fhswf/LEDScheinwerfer/ESP8266/3D-Daten/Servohalter-3DDruck.stl

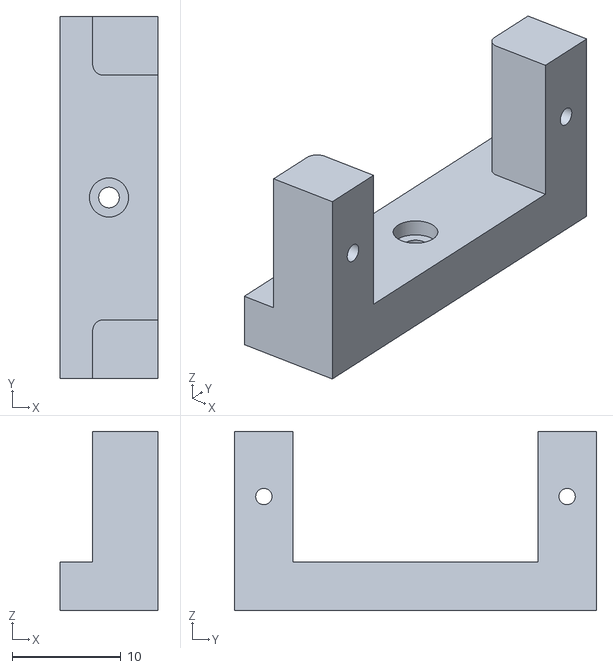
[picture p1: CAD file, 2024-04-04]
ESP8266/3D-Daten/Servohalter-3DDruck.stl
9.00 x 33.3 x 16.5
