fhswf/LEDScheinwerfer/ESP8266/3D-Daten/Seitenteil1.stl

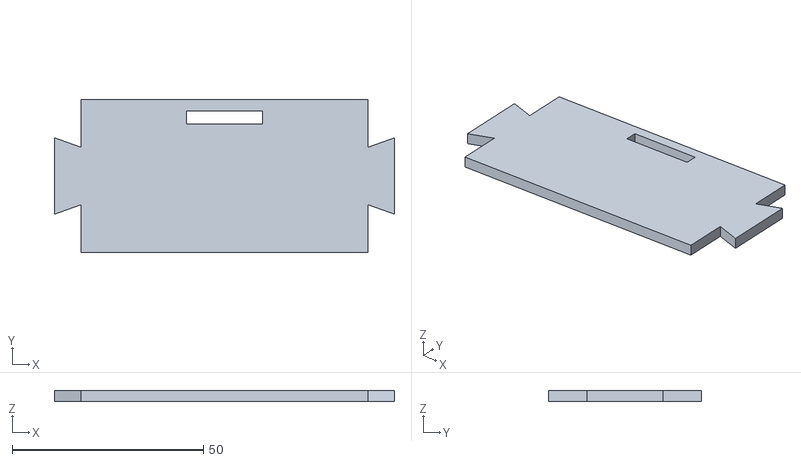
[picture p2: CAD file, 2024-04-04]
ESP8266/3D-Daten/Seitenteil1.stl
89.0 x 40.0 x 3.00
