fhswf/LEDScheinwerfer/ESP8266/3D-Daten/LED_Halter.stl

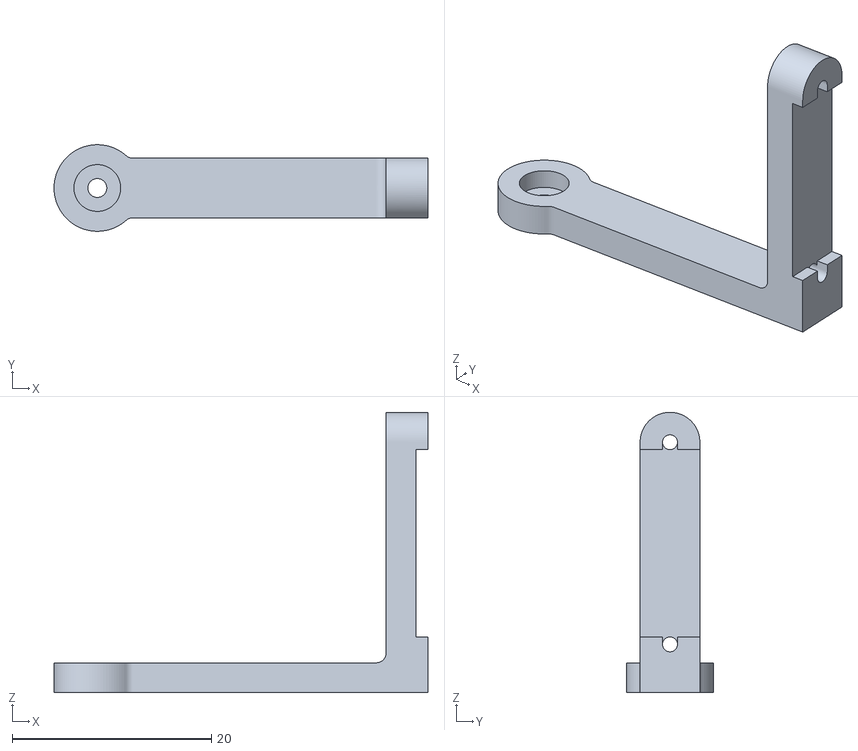
[picture p3: CAD file, 2024-04-04]
ESP8266/3D-Daten/LED_Halter.stl
37.5 x 8.70 x 28.1
