fhswf/LEDScheinwerfer/ESP8266/3D-Daten/Linse.stl

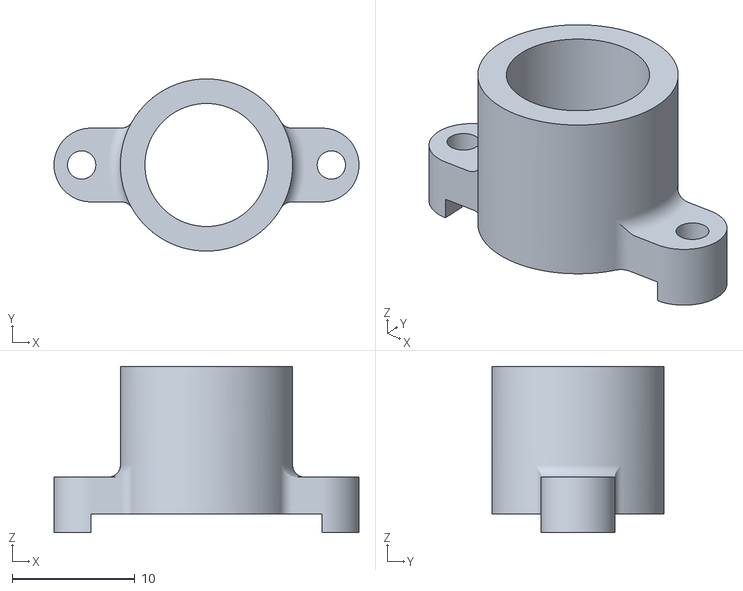
[picture p4: CAD file, 2024-04-04]
ESP8266/3D-Daten/Linse.stl
24.8 x 14.0 x 13.5
