fhswf/LEDScheinwerfer/ESP8266/3D-Daten/Platte.stl

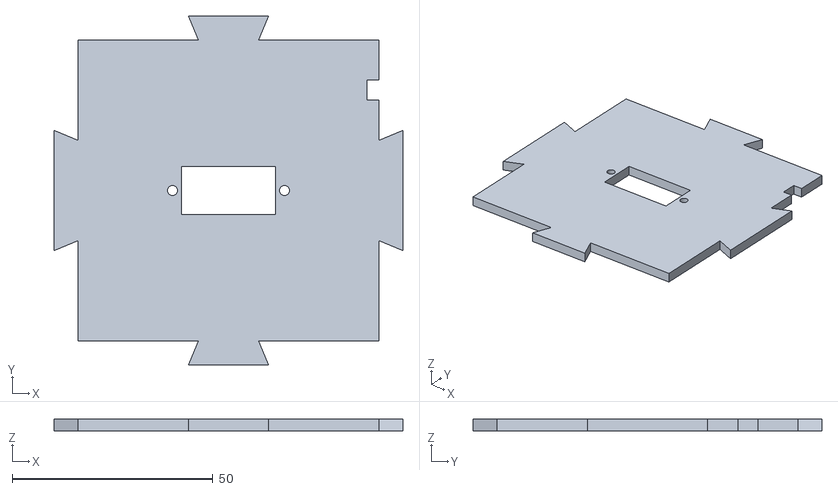
[picture p5: CAD file, 2024-04-04]
ESP8266/3D-Daten/Platte.stl
87.0 x 87.0 x 3.00
