fhswf/LEDScheinwerfer/ESP8266/3D-Daten/Seitenteil2_hinten.stl

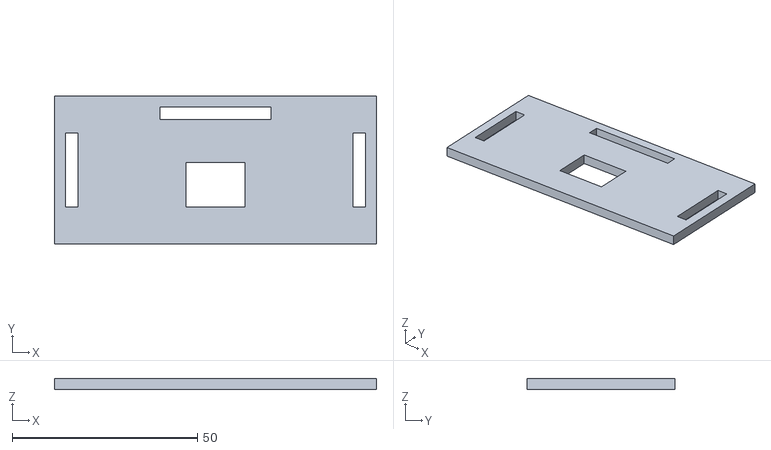
[picture p6: CAD file, 2024-04-04]
ESP8266/3D-Daten/Seitenteil2_hinten.stl
87.0 x 40.0 x 3.00
