fhswf/LEDScheinwerfer/ESP8266/3D-Daten/Gehäuse LED Scheinwerfer.pdf

1

3 2

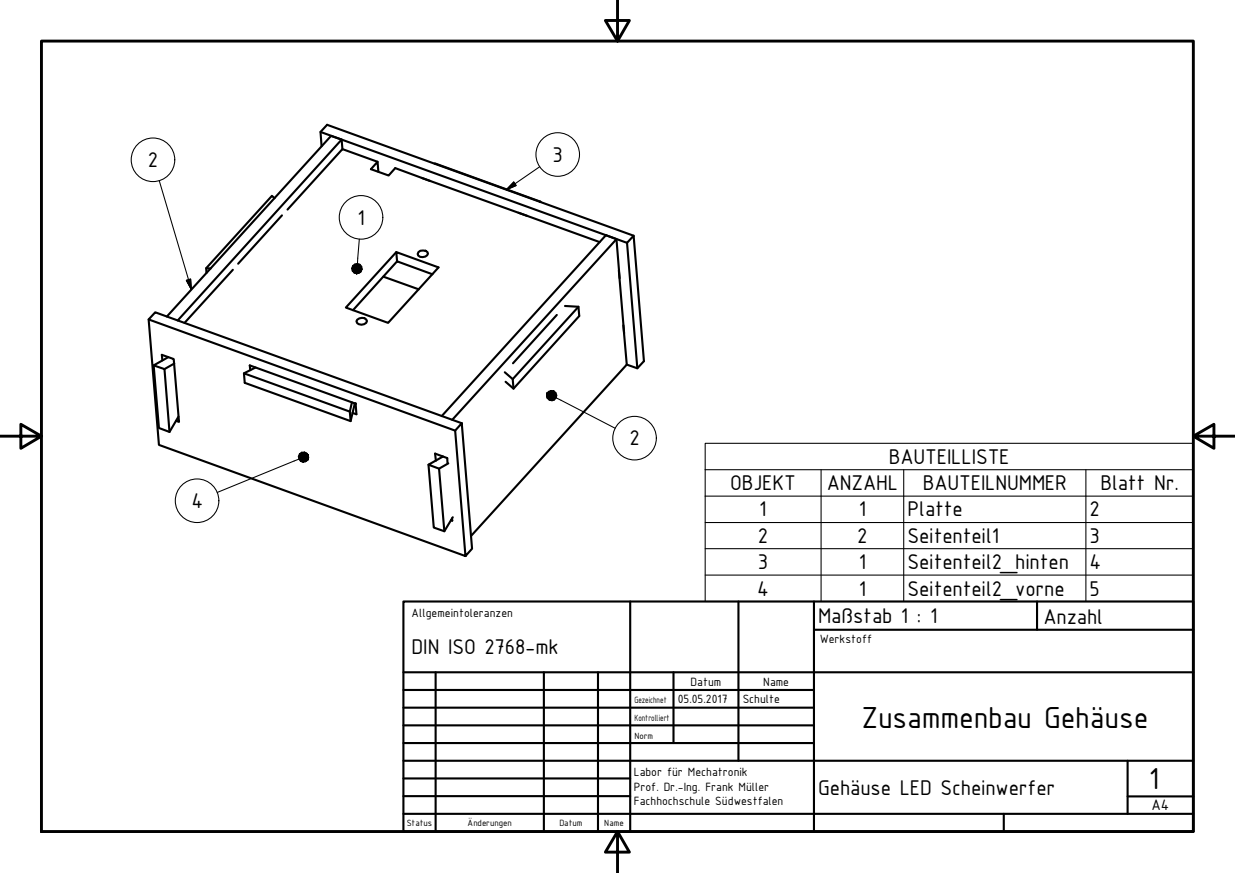
[picture p50: page 1]
BAUTEILLISTE; OBJEKT; ANZAHL; BAUTEILNUMMER; Blatt Nr.; Platte; Seitenteil1; Seitenteil2_hinten; Seitenteil2_vorne; Status; |nderungen; Datum; Name; Gezeichnet; Kontrolliert; Norm; Schulte; Mastab 1 : 1; Werkstoff; Anzahl

Allgemeintoleranzen
DIN ISO 2768-mk

Zusammenbau Gehuse

Labor f¯r Mechatronik
Prof. Dr.-Ing. Frank M¯ller
Fachhochschule S¯dwestfalen

Gehuse LED Scheinwerfer

20

15

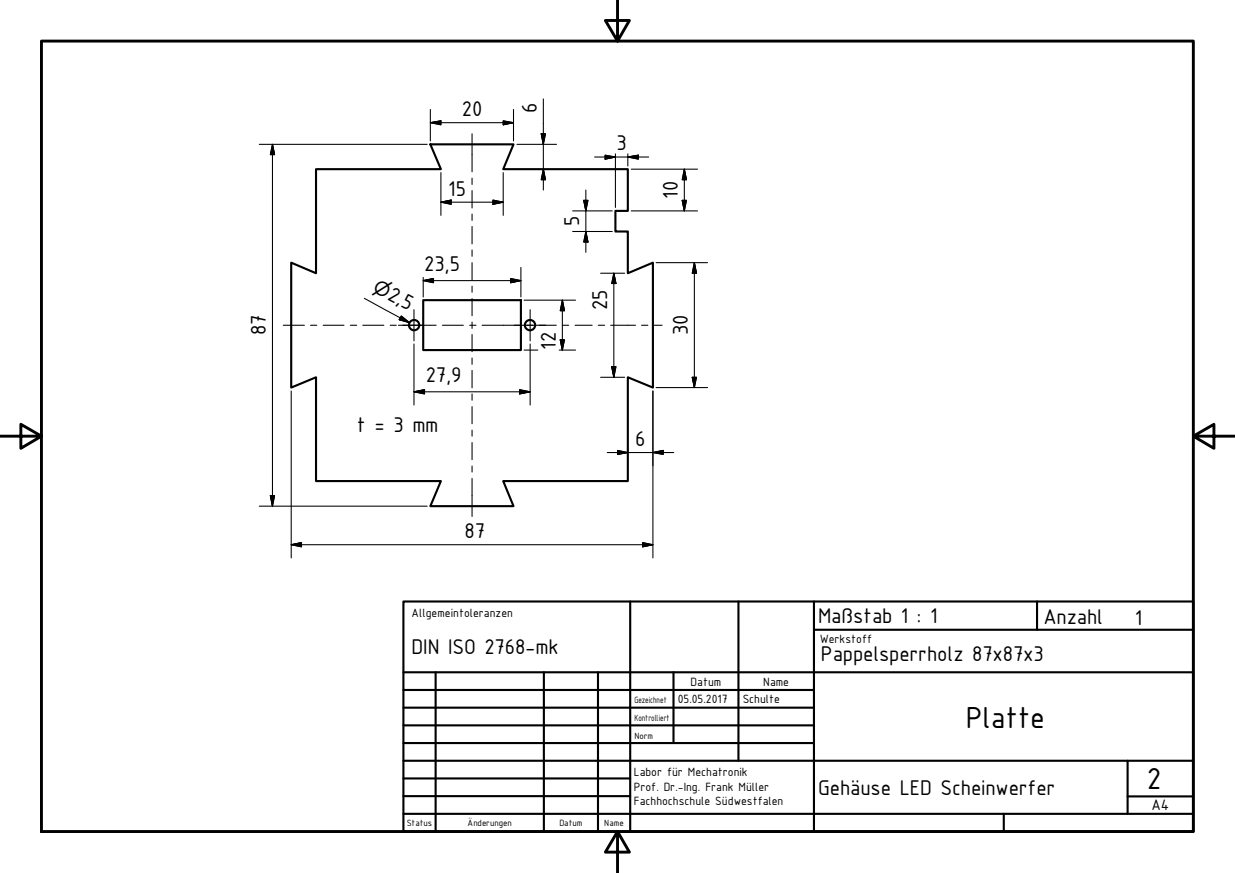
[picture p51: page 2]
Gezeichnet; Kontrolliert; Norm; Datum; Name; Schulte; Mastab 1 : 1; Werkstoff; Anzahl; Pappelsperrholz 87x87x3; Platte

Allgemeintoleranzen
DIN ISO 2768-mk

Labor f¯r Mechatronik
Prof. Dr.-Ing. Frank M¯ller

Gehuse LED Scheinwerfer

20

89

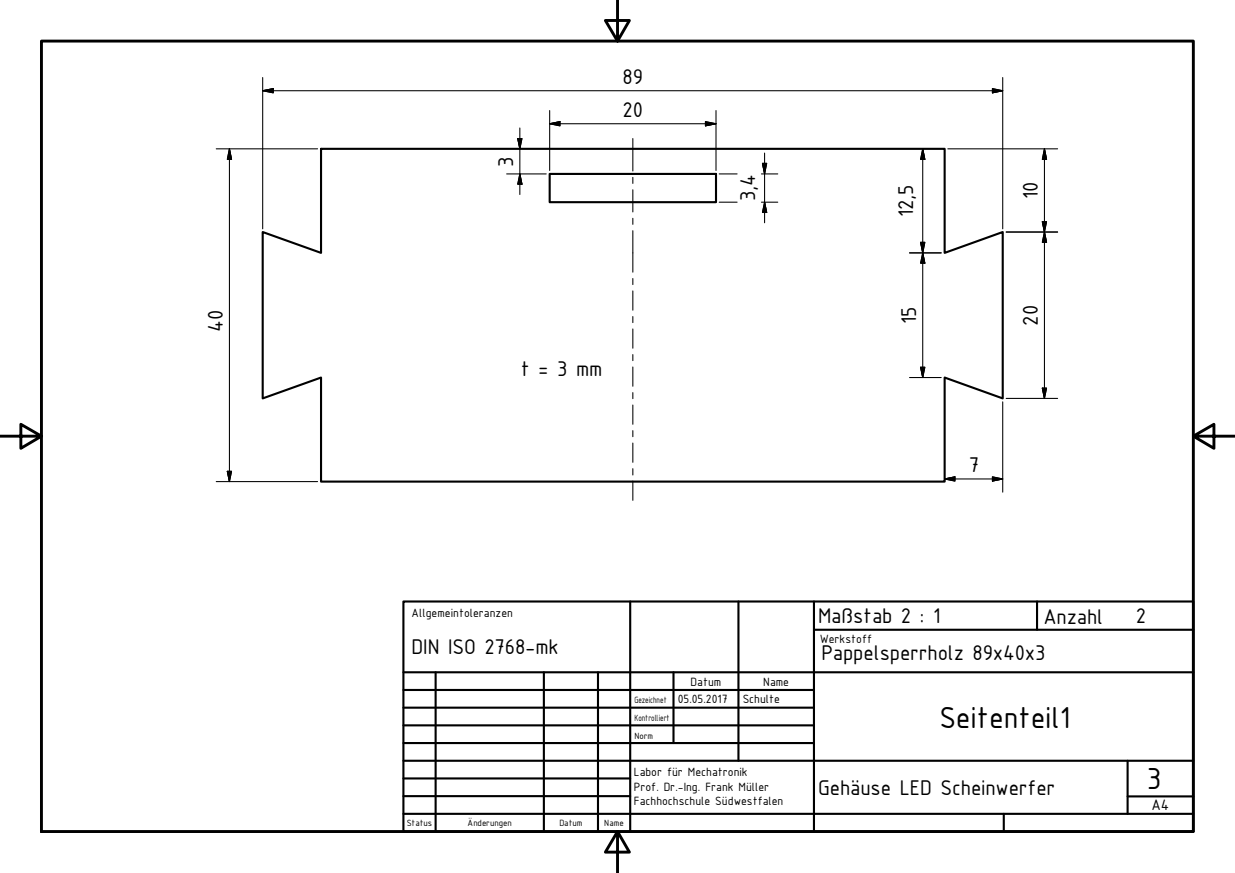
[picture p52: page 3]
Gezeichnet; Kontrolliert; Norm; Datum; Name; Schulte; Mastab 2 : 1; Werkstoff; Anzahl; Pappelsperrholz 89x40x3; Seitenteil1

Allgemeintoleranzen
DIN ISO 2768-mk

Labor f¯r Mechatronik
Prof. Dr.-Ing. Frank M¯ller

Gehuse LED Scheinwerfer

87

30

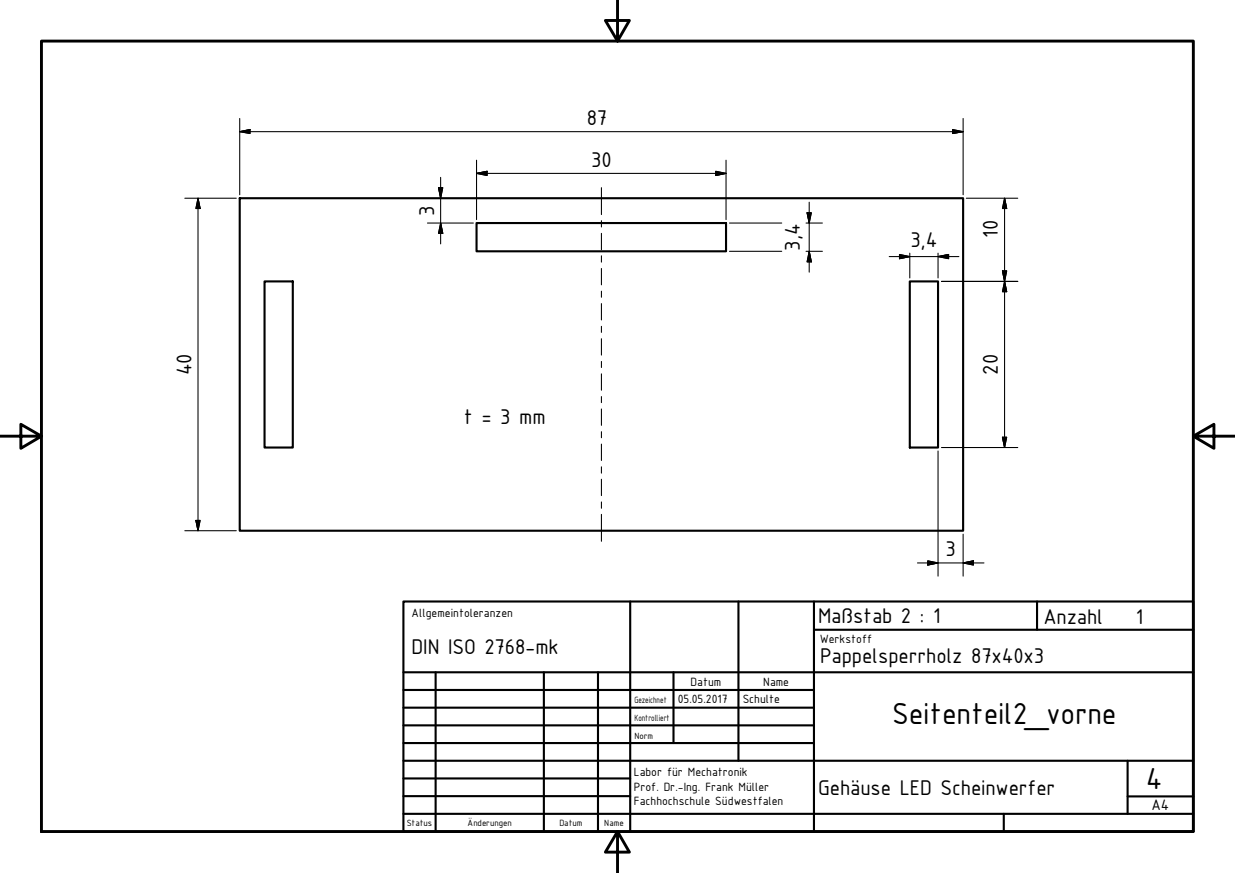
[picture p53: page 4]
Gezeichnet; Kontrolliert; Norm; Datum; Name; Schulte; Mastab 2 : 1; Werkstoff; Anzahl; Pappelsperrholz 87x40x3; Seitenteil2_vorne

Allgemeintoleranzen
DIN ISO 2768-mk

Labor f¯r Mechatronik
Prof. Dr.-Ing. Frank M¯ller

Gehuse LED Scheinwerfer

87

30

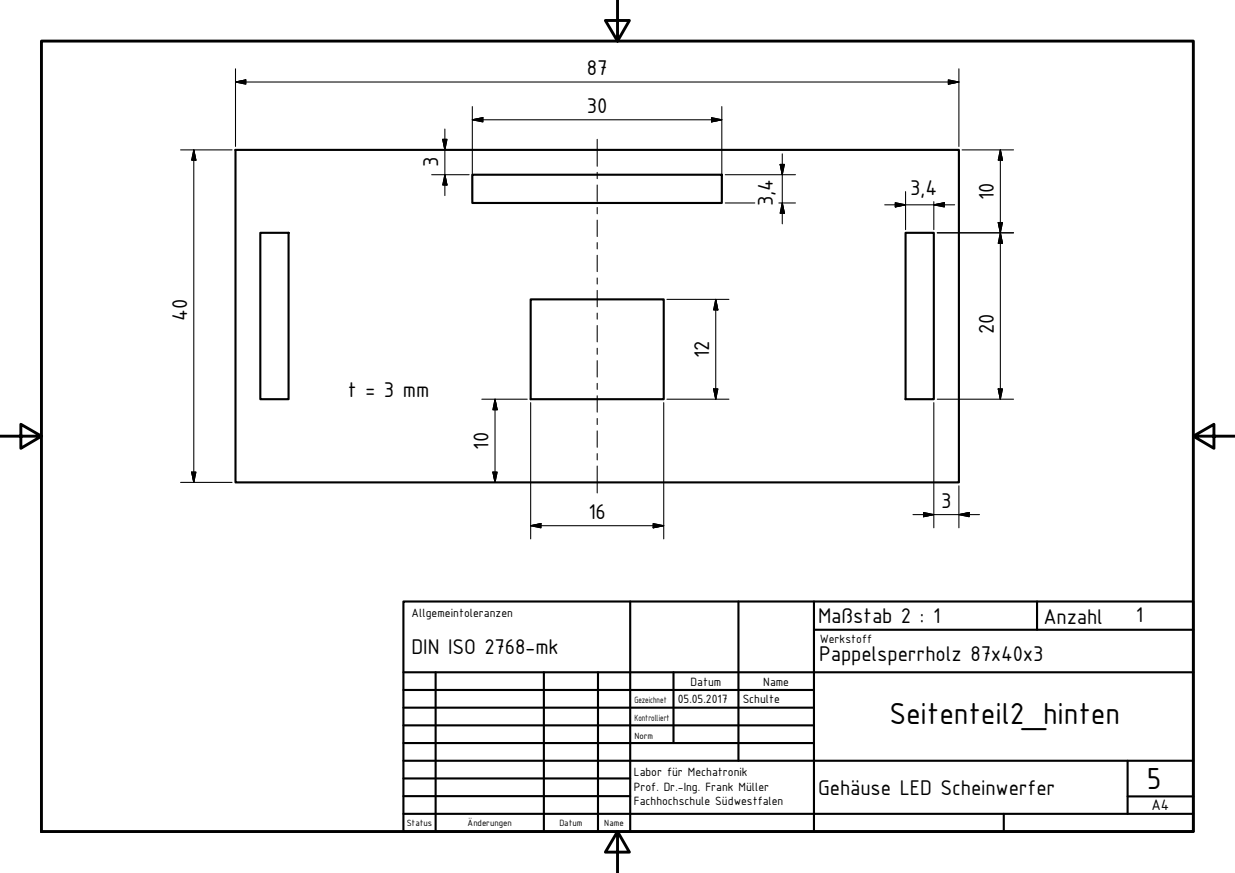
[picture p54: page 5]
Gezeichnet; Kontrolliert; Norm; Datum; Name; Schulte; Mastab 2 : 1; Werkstoff; Anzahl; Pappelsperrholz 87x40x3; Seitenteil2_hinten

Allgemeintoleranzen
DIN ISO 2768-mk

Labor f¯r Mechatronik
Prof. Dr.-Ing. Frank M¯ller

Gehuse LED Scheinwerfer
